RadmehrMoradkhani/TNY280-220VAC-TO-15VDC/README.md

# TNY280-220VAC-TO-15VDC
 TNY280-220VAC-TO-15VDC-1A
