RadmehrMoradkhani/TNY280-220VAC-TO-15VDC/TNY280-220VAC-TO-15VDC-1A/TinySwitch-III_PIDesign.pdf

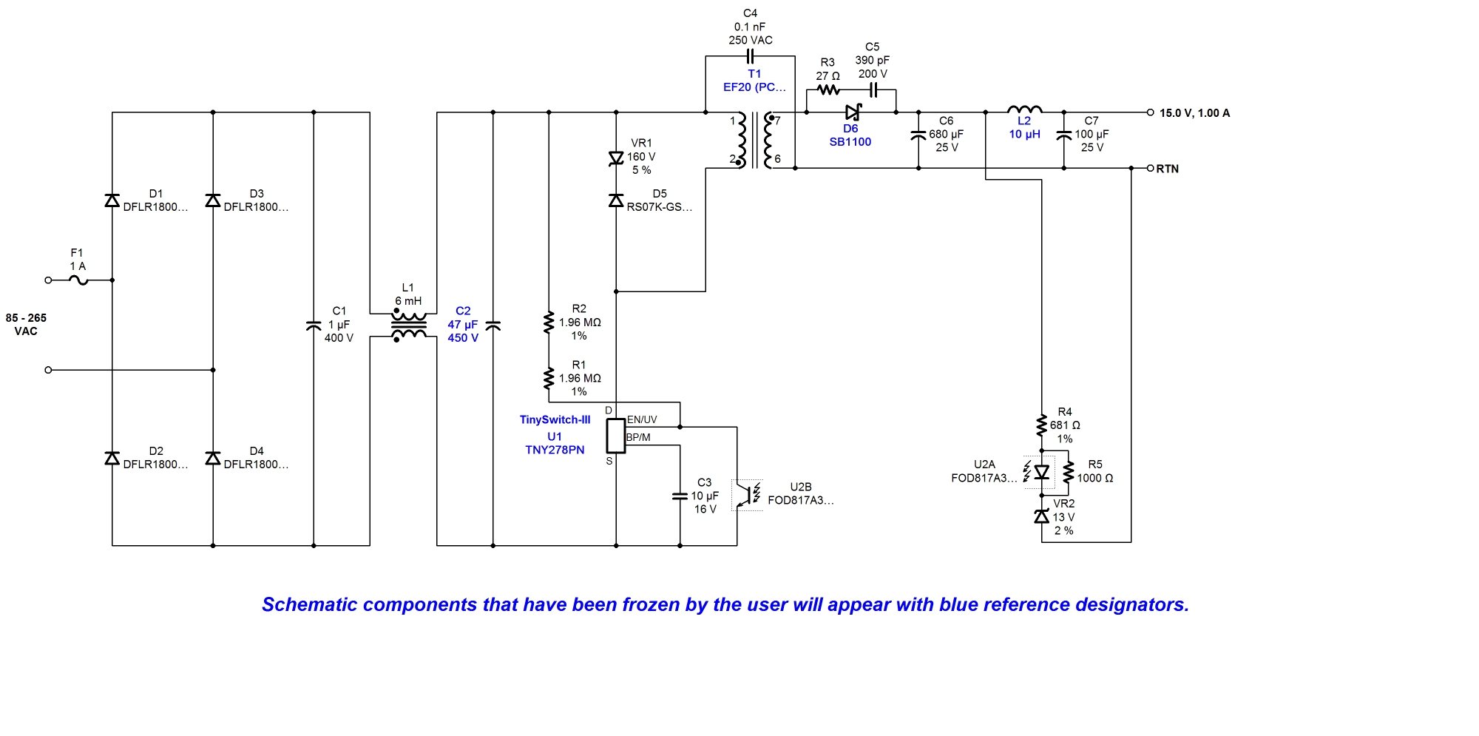
[picture p1: figure]

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

Core Type | EF20 (PC40EF20-Z) | Core Type (Manual Overwrite)
Core Material | PC40 | | Core Material
Primary Pins | 2 | | Number of Primary pins used
Secondary Pins | 2 | | Number of Secondary pins used
USE_SHIELDS | NO | | Use shield Windings
LP_nom | 780 | µH | Nominal Primary Inductance
LP_Tol | 12.0 | % | Primary Inductance Tolerance
NP | 102.2 | | Calculated Primary Winding Total Number of Turns
NSM | 12 | | Secondary Main Number of Turns
Primary Current Density | 4.88 | A/mm² | Primary Winding Current Density
VOR | 135.00 | V | Reflected Output Voltage
BW | 12.50 | mm | Bobbin Winding Width
FF | 60.17 | % | Actual Transformer Fit Factor. 100% signifies fully utilized winding window
AE | 33.50 | mm² | Core Cross Sectional Area
ALG | 66 | nH/T² | Gapped Core Specific Inductance
BM | 150 | mT | Maximum Flux Density
BAC | 53 | mT | AC Flux Density for Core Loss
LG | 0.614 | mm | Estimated Gap Length. See Information section for detail
L_LKG | 23.39 | µH | Estimated primary leakage inductance
LSEC | 20 | nH | Secondary Trace Inductance

### Primary Winding Section 1

Var | Value | Units | Description
NP1 | 103 | | Number of Primary Winding Turns in the First Section of Primary
L | 2.72 | | Primary Winding - Number of Layers
DC Copper Loss | 0.11 | W | Primary Section 1 DC Losses

### Output 1

Var | Value | Units | Description
VO | 15.00 | V | Typical Output Voltage
IO | 1.00 | A | Output Current
VOUT_ACTUAL | 15.00 | V | Actual Output Voltage
NS | 12 | | Secondary Number of Turns
L_S_OUT | 0.72 | | Secondary Output Winding Layers
DC Copper Loss | 0.20 | W | Secondary DC Losses
VD | 0.85 | V | Output Winding Diode Forward Voltage Drop (Manual Overwrite)
VD | 0.85 | V | Output Winding Diode Forward Voltage Drop (Manual Overwrite)
PIVS | 58.66 | V | Output Rectifier Maximum Peak Inverse Voltage
ISP | 5.153 | A | Peak Secondary Current
ISRMS | 2.012 | A | Secondary RMS Current
ISRMS_WINDING | 2.012 | A | Secondary Winding RMS Current
Secondary Current Density | 8 | A/mm² | Secondary Winding Current Density
RTH_RECTIFIER | 59.45 | °C/W | Output Rectifier Heatsink Maximum Thermal Resistance

OR_HSINK_TYPE | 2 Oz (70 µ) 2-Sided Copper PCB | Output Rectifier Heatsink Type
OR_HSINK_AREA | 99 | mm² | Output Rectifier Heatsink Area
CO | 680 x 1 | µF | Output Capacitor - Capacitance
IRIPPLE | 1.746 | A | Output Capacitor - RMS Ripple Current
Expected Lifetime | 33810 | hr | Output Capacitor - Expected Lifetime

The regulation and tolerances do not account for thermal drifting and component tolerance of the output diode forward voltage drop and voltage drops across the LC post filter. The actual voltage values are estimated at full load only.

Please verify cross regulation performance on the bench.

### Board Layout Recommendations

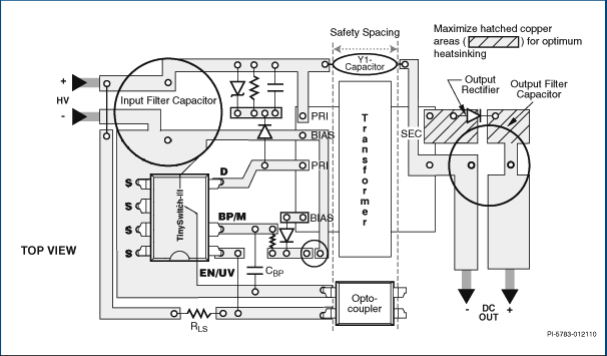
[picture p2: figure]

Click on the "Show me" icon to highlight relevant areas on the sample layout.

| Description | Show Me
1 | Maximize source area for good heat-sinking
2 | Keep drain trace short
3 | The BYPASS pin capacitor should be located as close as possible to the BYPASS and SOURCE pins
4 | Keep noisy traces away from EN/UV pin
5 | Route bias winding currents back to the bulk cap
6 | Keep clamp loop short
7 | Connect Y capacitor to the B+ rail on the primary side for better surge immunity. Keep Y capacitor traces short
8 | The area of the loop connecting the secondary winding, the output rectifier and the output filter capacitor should be minimized

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

### Electrical Diagram

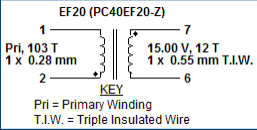
[picture p3: figure]

### Mechanical Diagram

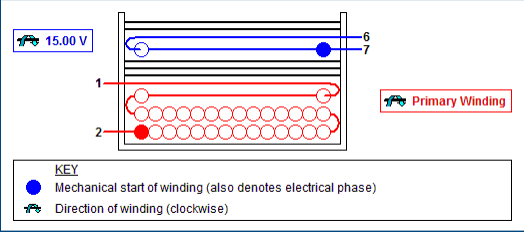
[picture p4: figure]

### Winding Instruction

Primary Winding
Start on pin(s) 2 and wind 103 turns (x 1 filar) of item [5]. in 3 layer(s) from left to right. Winding direction is clockwise. At the end of 1st layer, continue to wind the next layer from right to left. At the end of 2nd layer, continue to wind the next layer from left to right. On the final layer, spread the winding evenly across entire bobbin. Finish this winding on pin(s) 1.

Add 3 layers of tape, item [3], for insulation.

Secondary Winding
Start on pin(s) 7 and wind 12 turns (x 1 filar) of item [6]. Spread the winding evenly across entire bobbin. Winding direction is clockwise. Finish this winding on pin(s) 6.

Add 2 layers of tape, item [3], for insulation.

Core Assembly
Assemble and secure core halves. Item [1].

Varnish
Dip varnish uniformly in item [4]. Do not vacuum impregnate.

### Comments

1. For non margin wound transformers use triple insulated wire for all secondary windings.

### Materials

Item | Description
[1] Core: EF20 (PC40EF20-Z), PC40, gapped for ALG of 66 nH/T²
[2] Bobbin: Generic, 5 pri. + 5 sec.
[3] Barrier Tape: Polyester film [1 mil (25 µm) base thickness], 12.50 mm wide

[4] Varnish
[5] Magnet Wire: 0.28 mm, Solderable Double Coated
[6] Triple Insulated Wire: 0.55 mm

### Electrical Test Specifications

Parameter | Condition | Spec
Electrical Strength, VAC | 60 Hz 1 second, from pins 1,2 to pins 6,7. | 3000
Nominal Primary Inductance, µH | Measured at 1 V pk-pk, typical switching frequency, between pin 1 to pin 2, with all other Windings open. | 780
Tolerance, ±% | Tolerance of Primary Inductance | 12.0
Maximum Primary Leakage, µH | Measured between Pin 1 to Pin 2, with all other Windings shorted. | 23.39

Although the design of the software considered safety guidelines, it is the user's responsibility to ensure that the user's power supply design meets all applicable safety requirements of user's product.

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

1 | Design Passed (No Optimization)
Description | Fix | Ref. #
Gap length too big. | Decrease transformer size, decrease secondary turns (NS), decrease KP. | 217
Selected Post Filter values are too large on output(s) '1'. | Reduce post filter values such that resonant frequency is above 8 kHz (30 kHz for DPASwitch) | 175
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
