RadmehrMoradkhani/TNY280-220VAC-TO-15VDC/(list of files, drawings)

Other design files:
TNY280-220VAC-TO-15VDC-1A/Power15V0_1A.PcbDoc
TNY280-220VAC-TO-15VDC-1A/Power15V0_1A.PrjPcb
TNY280-220VAC-TO-15VDC-1A/Power15V0_1A.SchDoc
